pouyanasgari96/Microstrip_LPF/S21.png

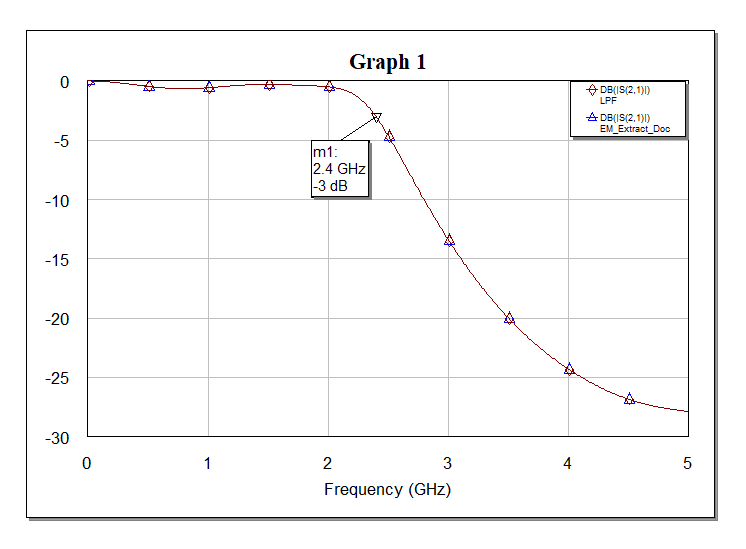
S21.png
